jacoblgit/Ball-Beam-Robot/code/Ball-Beam/architecture_design/system_architecture.jpeg

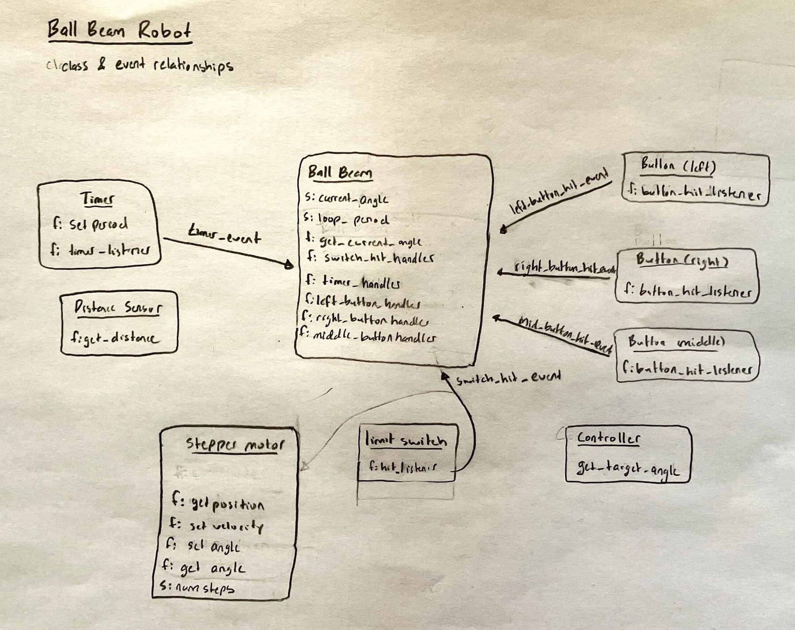
code/Ball-Beam/architecture_design/system_architecture.jpeg
