jacoblgit/Ball-Beam-Robot/portfolio/actual.JPG

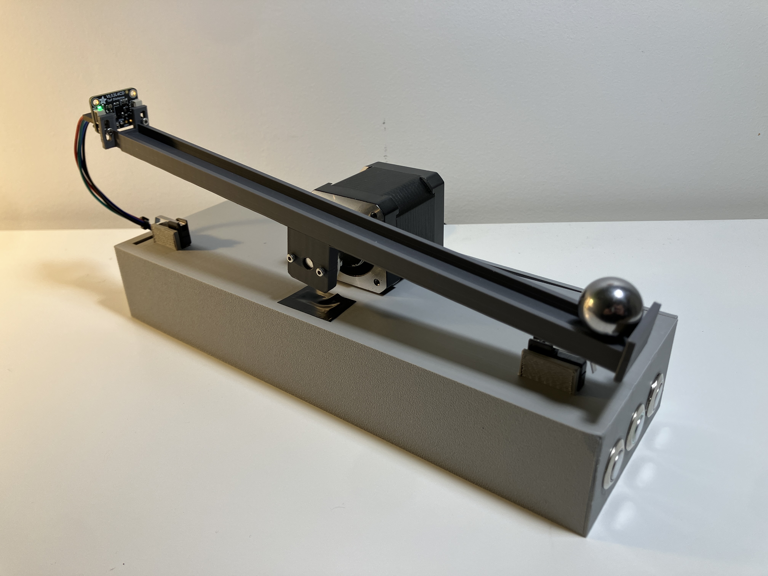
portfolio/actual.JPG
