jacoblgit/Ball-Beam-Robot/portfolio/altium.jpg

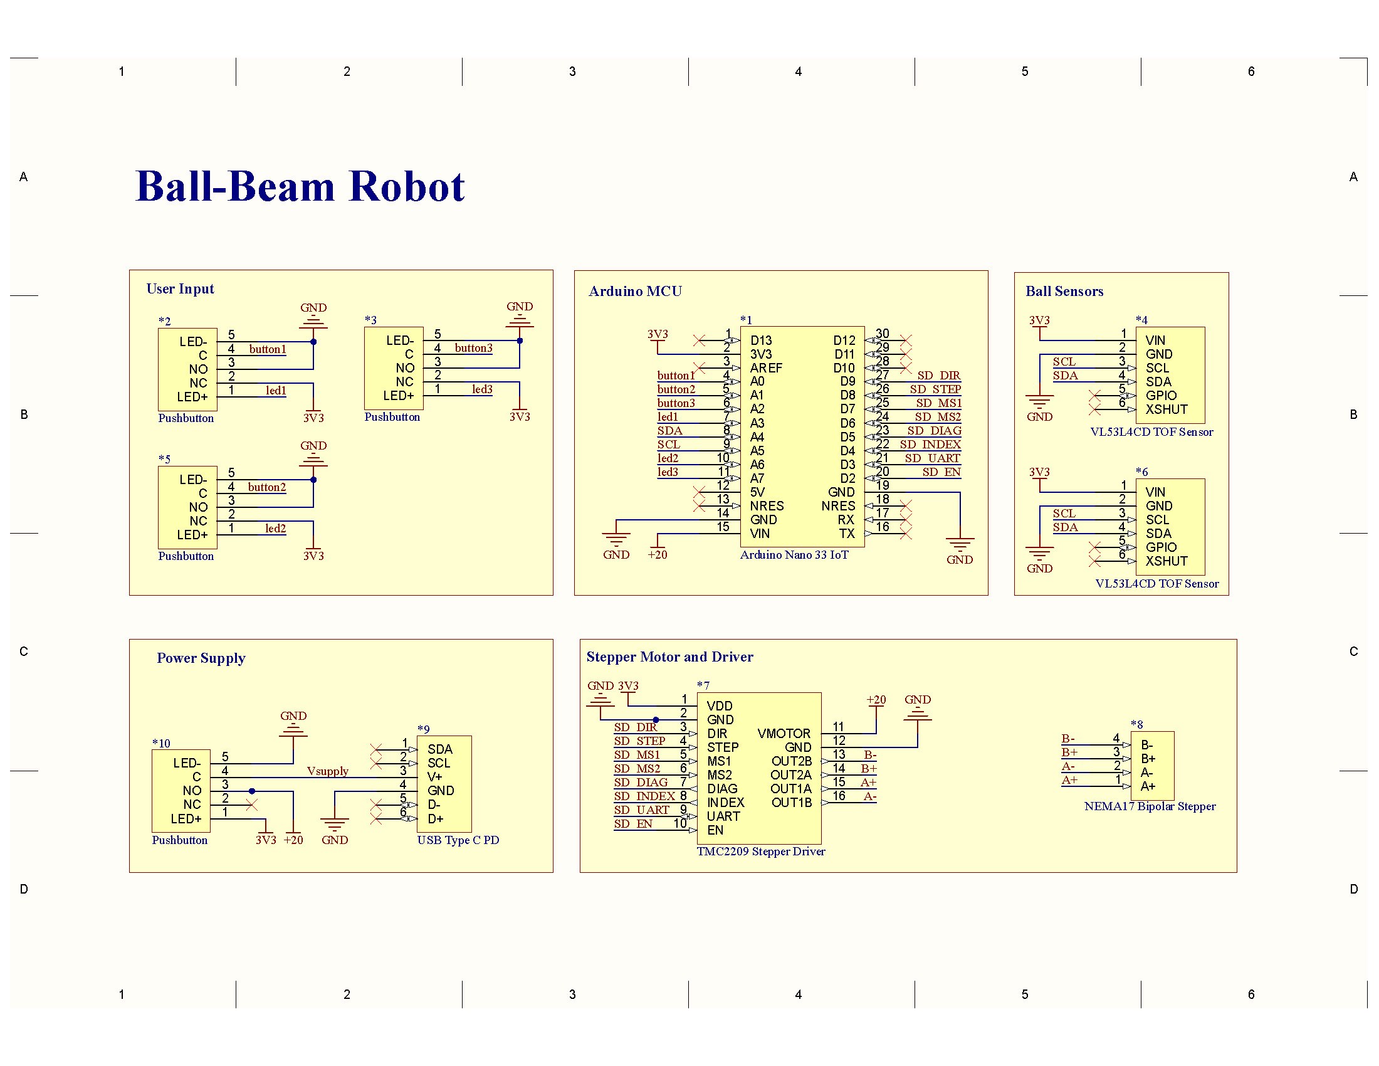
portfolio/altium.jpg
