jacoblgit/Ball-Beam-Robot/portfolio/cad.png

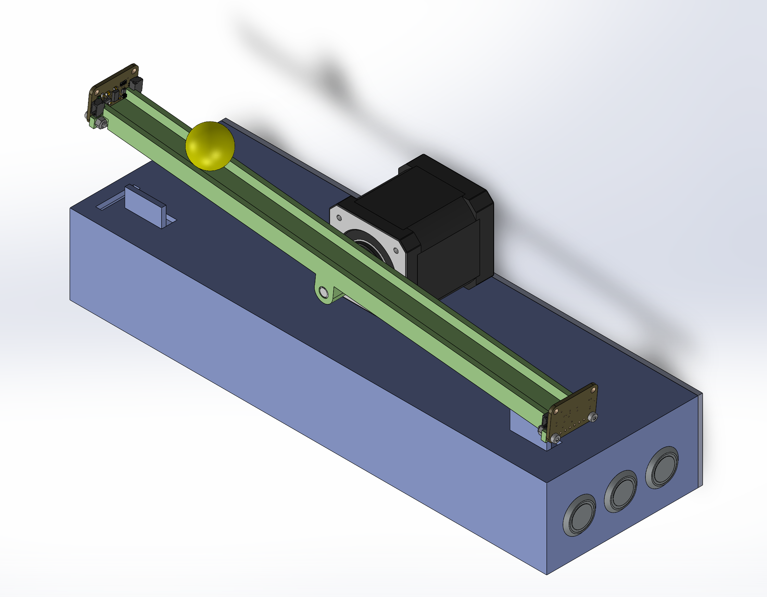
portfolio/cad.png
