jacoblgit/Ball-Beam-Robot/portfolio/matlab4.png

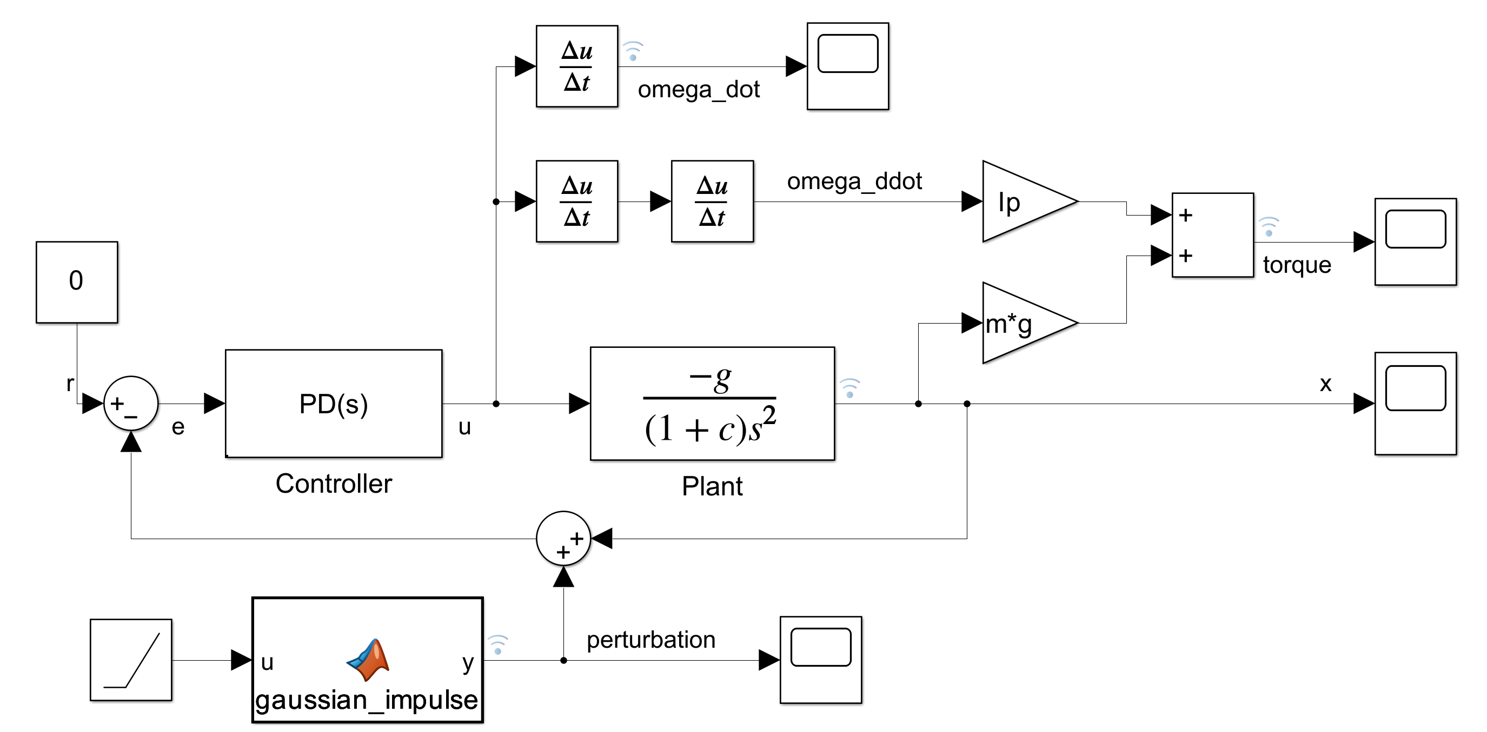
portfolio/matlab4.png
