jacoblgit/Ball-Beam-Robot/portfolio/Screenshot 2025-01-07 003946.png

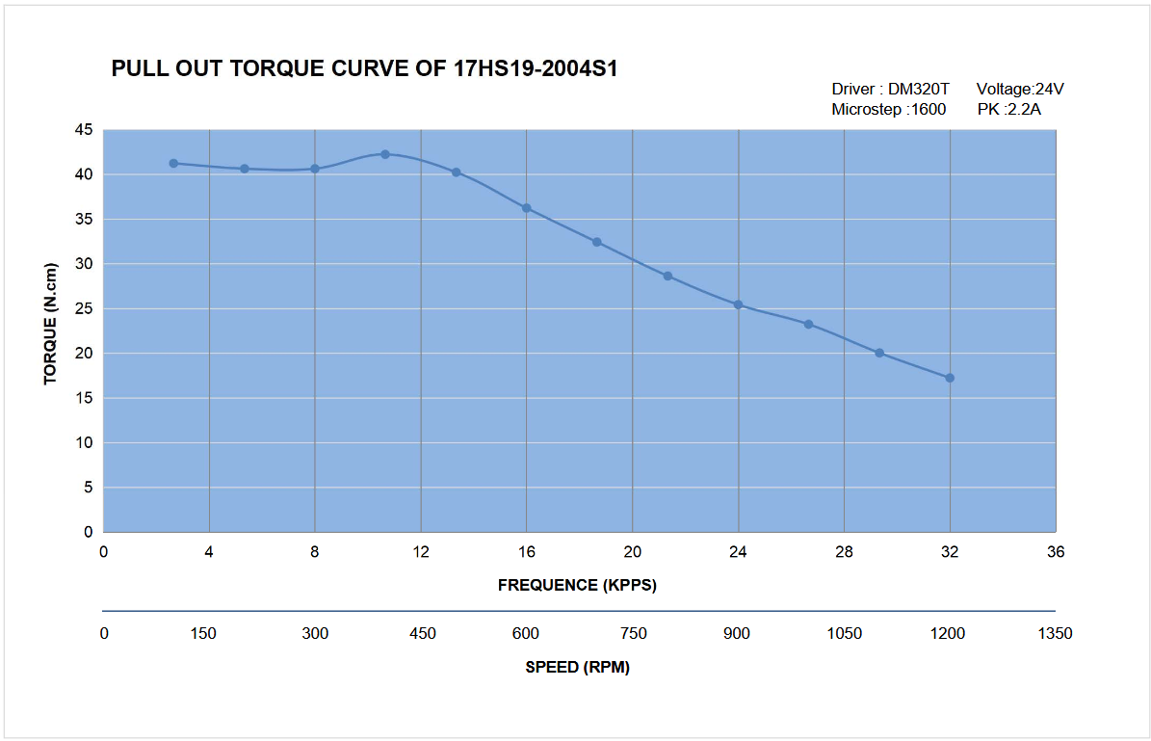
portfolio/Screenshot 2025-01-07 003946.png
