jacoblgit/Ball-Beam-Robot/CAW.xlsx

Ball Beam Cost Accounting Worksheet
Item | ID | Quantity | Price | Total | Link | Ordered
Electronics
Adafruit TMC2209 Stepper Motor Driver Breakout Board | 6121 | 1 | 8.95 | $8.95 | https://www.adafruit.com/product/6121 | 2025-01-15
Adafruit USB Type C Power Delivery Dummy Breakout - I2C or Fixed - HUSB238 | 5807 | 1 | 5.95 | $5.95 | https://www.adafruit.com/product/5807 | 2025-01-15
Adafruit VL53L4CD Time of Flight Distance Sensor | 5396 | 2 | $14.95 | $29.90 | https://www.adafruit.com/product/5396 | 2025-01-15
Rugged Metal On/Off Switch with White LED Ring - 16mm | 917 | 1 | $4.95 | $4.95 | https://www.adafruit.com/product/917 | 2025-01-15
Rugged Metal Pushbutton with White LED Ring - 16mm White Momentary | 558 | 3 | $4.95 | $14.85 | https://www.adafruit.com/product/558 | 2025-01-15
Arcade Button Quick-Connect Wire Pairs - 0.11" (10 pack) | 1152 | 2 | $4.95 | $9.90 | https://www.adafruit.com/product/1152 | 2025-01-15
Motor
Stepper Motor | 17HS19-2004S1 | 1 | $9.62 | $0.00 | https://www.omc-stepperonline.com/nema-17-bipolar-59ncm-84oz-in-2a-42x48mm-4-wires-w-1m-cable-connector-17hs19-2004s1 | personal stock
Motor Dampener | ST-D1 | 1 | $2.18 | $0.00 | https://www.omc-stepperonline.com/nema-17-stepper-motor-vibration-dampers-with-4-m3-screws-st-d1 | personal stock
Motor Bracket | ST-M1 | 1 | $1.84 | $1.84 | https://www.omc-stepperonline.com/nema-17-bracket-for-stepper-motor-and-geared-stepper-motor-alloy-steel-bracket-st-m1 | 2025-01-15
Power Transfer
GT2 Pinion | 3422-0005-0020 | 2 | $6.99 | $13.98 | https://www.servocity.com/2mm-pitch-gt2-pinion-timing-pulley-5mm-bore-20-tooth/ | 2025-01-15
5mm ID Non-Flanged Bearing | 1600-0410-0005 | 1 | $3.99 | $3.99 | https://www.servocity.com/5mm-id-x-10mm-od-non-flanged-ball-bearing-2-pack/ | 2025-01-15
5mm Shaft (Stainless Steel, 50mm Length) | 2100-0005-0050 | 1 | $1.59 | $1.59 | https://www.servocity.com/5mm-shaft-stainless-steel-50mm-length/ | 2025-01-15
2mm Pitch GT2 Timing Belt | 3423-0006-0088 | 1 | $1.49 | $1.49 | https://www.servocity.com/2mm-pitch-gt2-timing-belt-6mm-width-88mm-pitch-length-44-tooth/ | 2025-01-15
Miscelaneous
Assorted M2 M3 M4 M5 Nuts and Bolts | SYD-517 | 1 | $24.99 | $0 | https://a.co/d/aZ3D2kg | personal stock
3/4" chrome steel ball bearing | NA | 1 | $7.99 | $7.99 | https://a.co/d/1f6xndt | 2025-01-15
 |  |  | Total | $105.38
