jacoblgit/Ball-Beam-Robot/design/3D_printing/pillar.STL

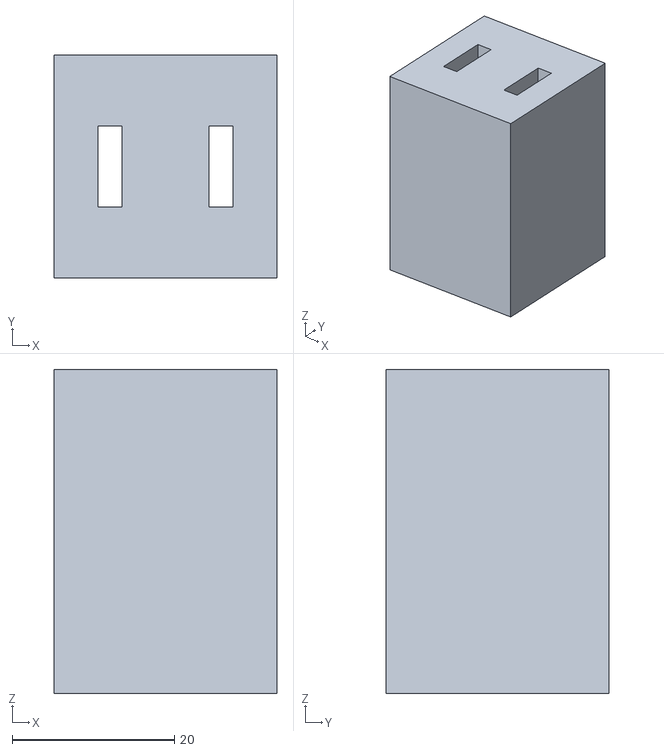
[picture p7: CAD file, 2025-01-11]
design/3D_printing/pillar.STL
27.5 x 27.5 x 40.0
