jacoblgit/Ball-Beam-Robot/design/back_cover.SLDPRT

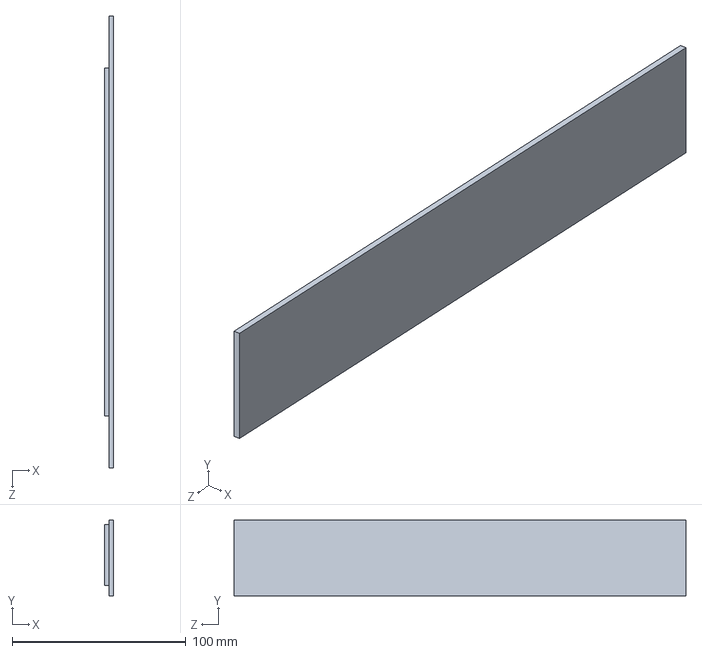
[picture p8: CAD file, 2025-05-26]
design/back_cover.SLDPRT
5.00 x 43.5 x 260.0 mm
