jacoblgit/Ball-Beam-Robot/design/electronics/OTS/5807 HUSB238 Breakout.step

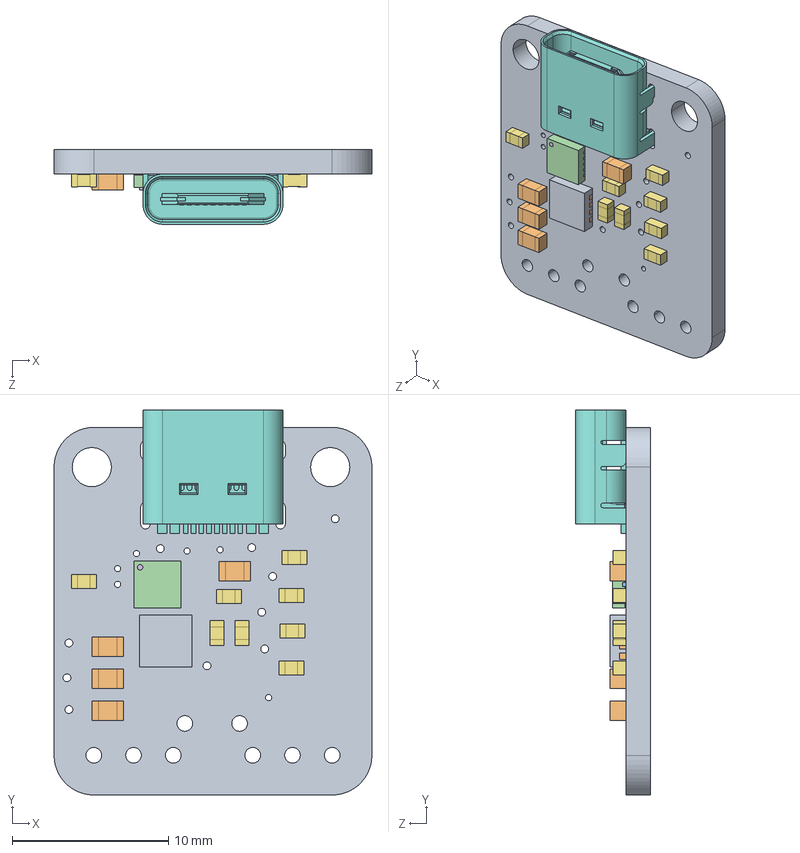
[picture p9: CAD file, 2025-01-18]
design/electronics/OTS/5807 HUSB238 Breakout.step
20.3 x 24.6 x 4.77 mm
Board.step
4.7uF.step x 4
HUSB238.step
14K.step x 8
USB Type C.step
AONR21307.step
