jacoblgit/Ball-Beam-Robot/design/3D_printing/pillar_pivot.STL

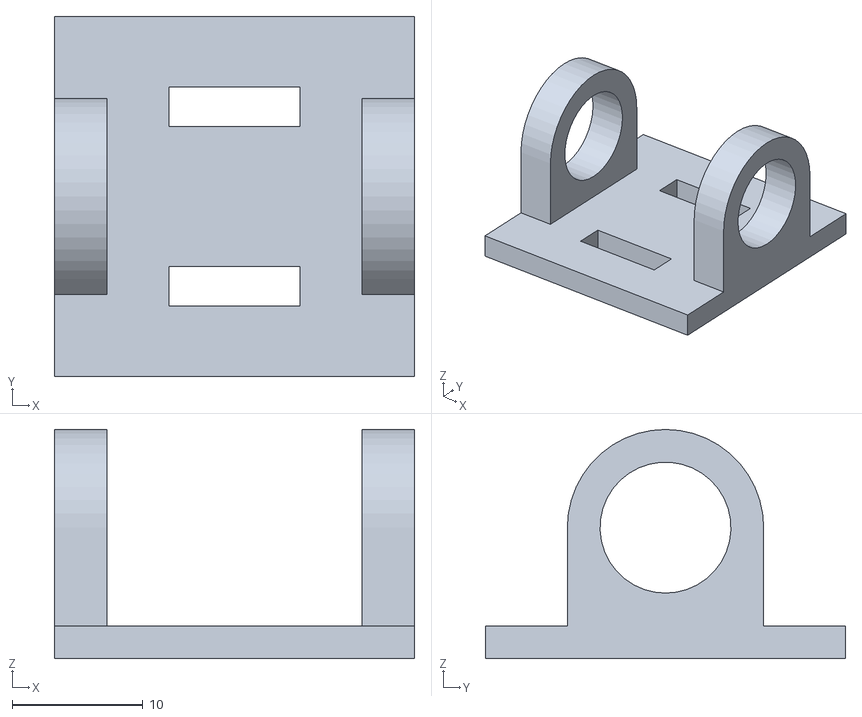
[picture p10: CAD file, 2025-01-11]
design/3D_printing/pillar_pivot.STL
27.5 x 27.5 x 17.5
