jacoblgit/Ball-Beam-Robot/design/track_v2.SLDPRT

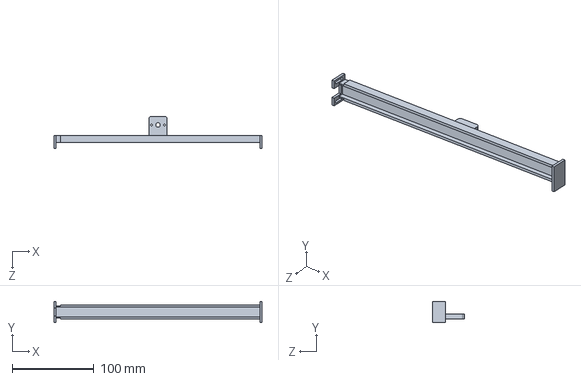
[picture p12: CAD file, 2025-05-26]
design/track_v2.SLDPRT
255.0 x 26.0 x 38.9 mm
