jacoblgit/Ball-Beam-Robot/design/ball.SLDPRT

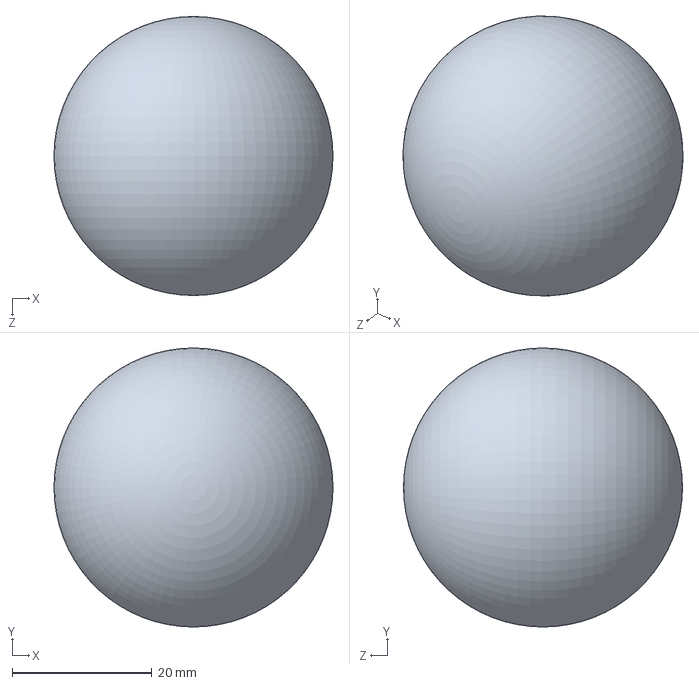
[picture p13: CAD file, 2025-05-26]
design/ball.SLDPRT
40.0 x 40.0 x 40.0 mm
