jacoblgit/Ball-Beam-Robot/design/track.SLDPRT

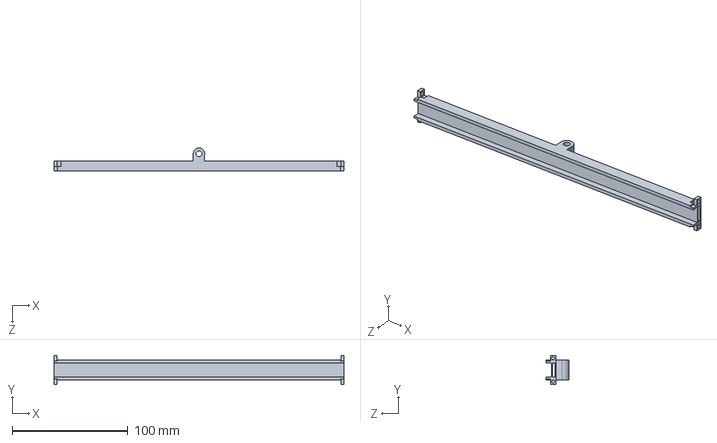
[picture p14: CAD file, 2025-05-26]
design/track.SLDPRT
250.1 x 25.4 x 20.0 mm
