jacoblgit/Ball-Beam-Robot/design/plate.SLDPRT

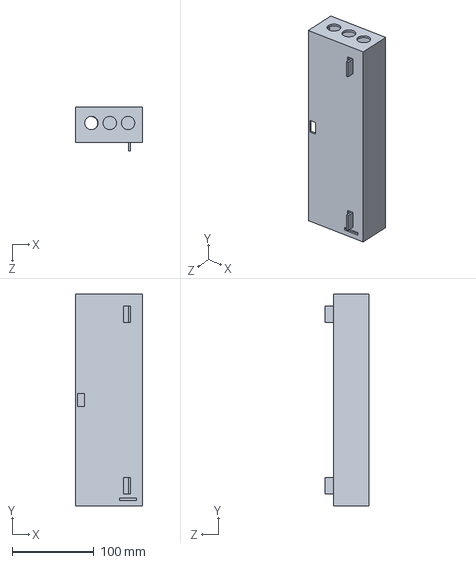
[picture p15: CAD file, 2025-05-26]
design/plate.SLDPRT
82.5 x 260.0 x 53.5 mm
