jacoblgit/Ball-Beam-Robot/design/OTS/Metal_Pushbutton_White.SLDPRT

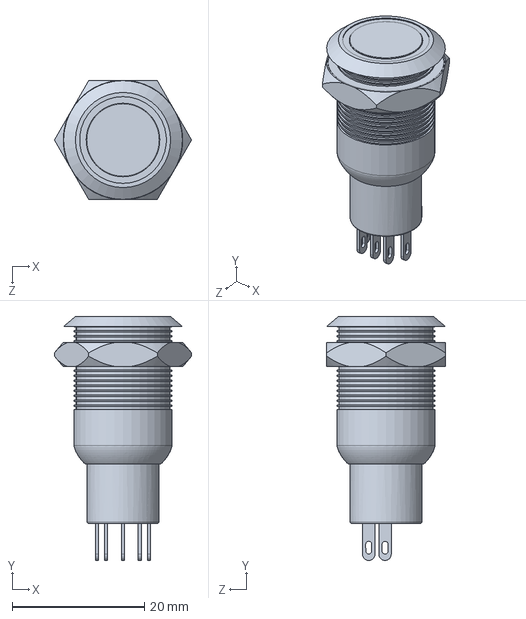
[picture p16: CAD file, 2025-01-07]
design/OTS/Metal_Pushbutton_White.SLDPRT
20.8 x 36.9 x 18.0 mm
