jacoblgit/Ball-Beam-Robot/design/OTS/17HS19-2004S1.STEP

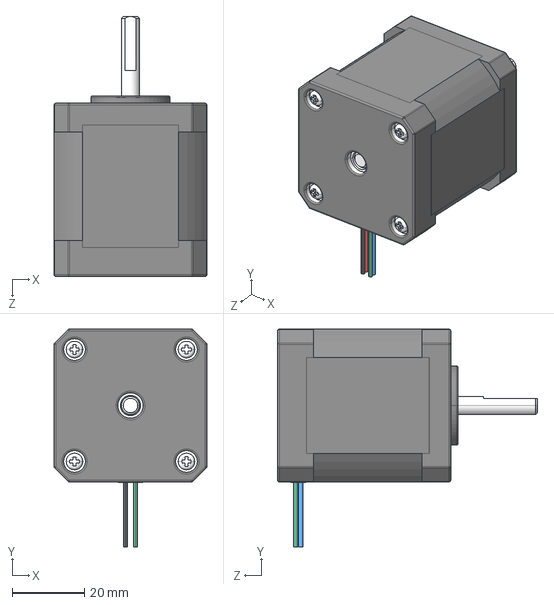
[picture p17: CAD file, 2025-01-05]
design/OTS/17HS19-2004S1.STEP
42.3 x 60.3 x 72.0 mm
