jacoblgit/Ball-Beam-Robot/design/OTS/3422-0005-0020.STEP

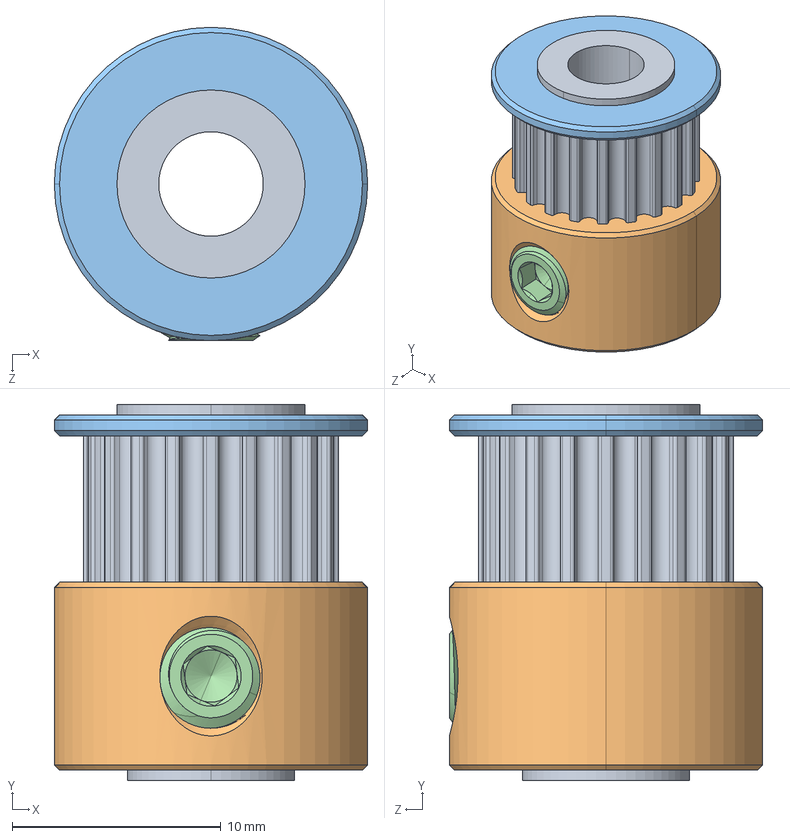
[picture p18: CAD file, 2025-01-05]
design/OTS/3422-0005-0020.STEP
15.0 x 18.0 x 15.0 mm
3422-0005-0020 core
3422 series barrel
3422 series flange
2806-0005-0005_91390A117
