jacoblgit/Ball-Beam-Robot/design/OTS/ST-M1.STEP

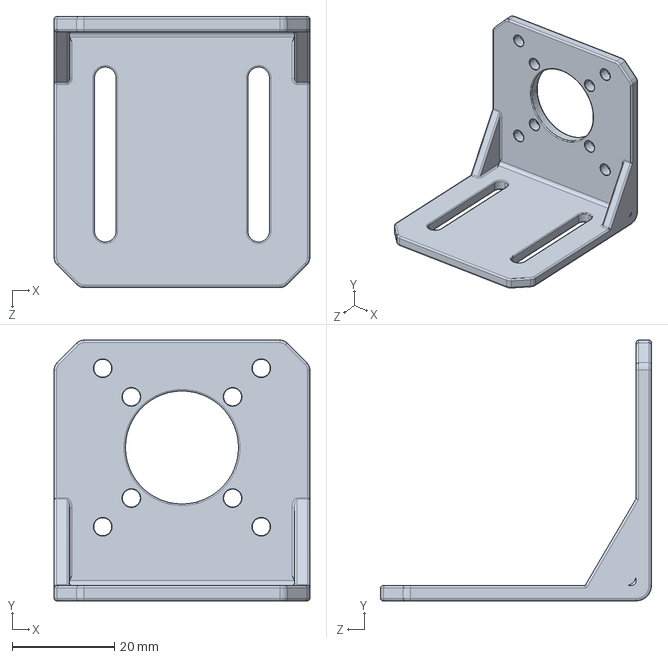
[picture p19: CAD file, 2025-01-05]
design/OTS/ST-M1.STEP
50.0 x 51.0 x 53.0 mm
