jacoblgit/Ball-Beam-Robot/design/OTS/Nema17-Damper.stp

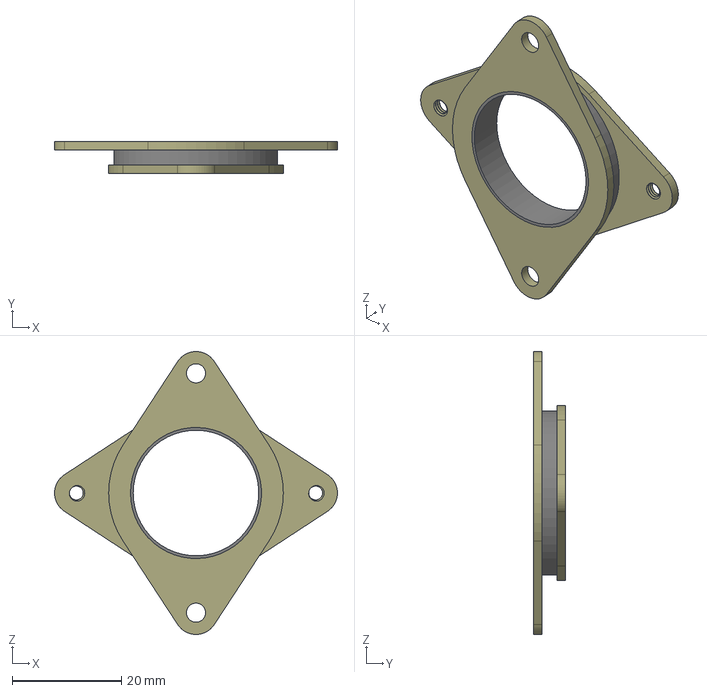
[picture p20: CAD file, 2025-01-05]
design/OTS/Nema17-Damper.stp
51.8 x 5.90 x 51.8 mm
