jacoblgit/Ball-Beam-Robot/design/OTS/2100-0005-0050.STEP

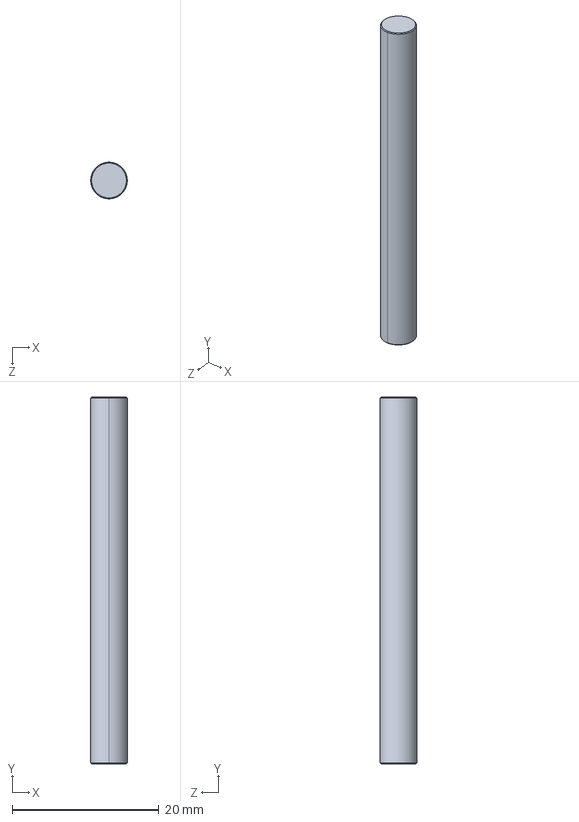
[picture p21: CAD file, 2025-01-05]
design/OTS/2100-0005-0050.STEP
5.00 x 50.0 x 5.00 mm
