jacoblgit/Ball-Beam-Robot/design/OTS/90576A211_Medium-Strength Steel Nylon-Insert Locknut.SLDPRT

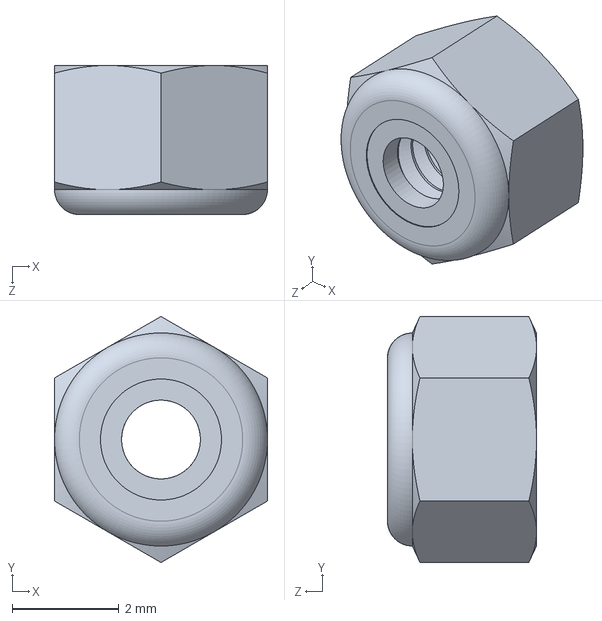
[picture p22: CAD file, 2025-01-08]
design/OTS/90576A211_Medium-Strength Steel Nylon-Insert Locknut.SLDPRT
4.00 x 4.62 x 2.80 mm
