jacoblgit/Ball-Beam-Robot/design/OTS/90037A110_High-Strength 316 Stainless Steel Socket Head Screw.SLDPRT

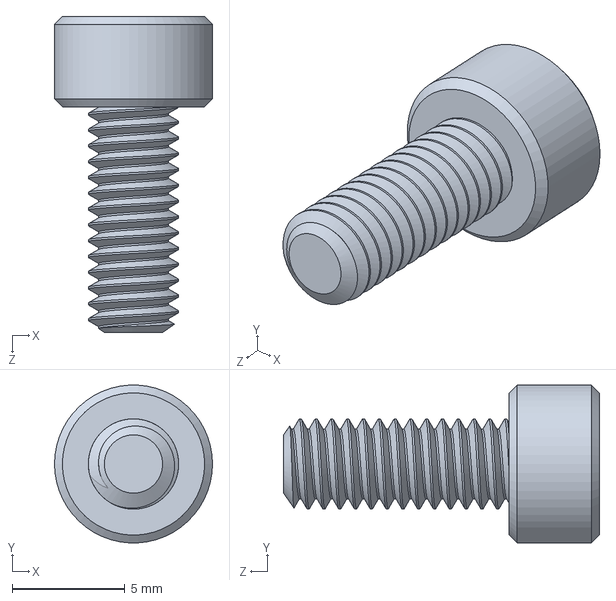
[picture p23: CAD file, 2025-01-08]
design/OTS/90037A110_High-Strength 316 Stainless Steel Socket Head Screw.SLDPRT
7.00 x 6.99 x 14.0 mm
