jacoblgit/Ball-Beam-Robot/design/system.SLDASM

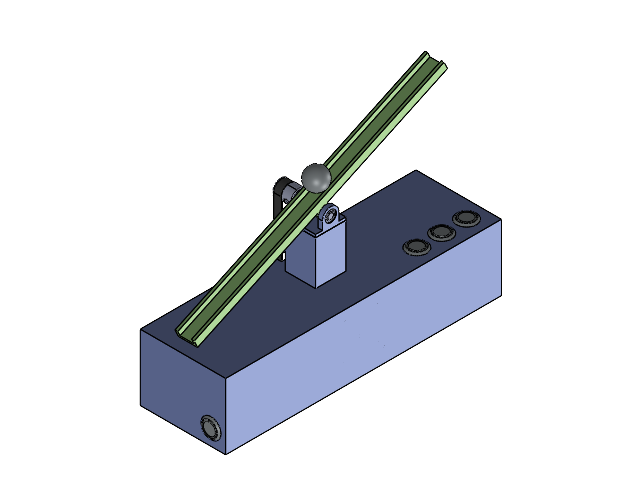
[picture p24: CAD file, 2025-01-07]
design/system.SLDASM
track
ball
plate
17HS19-2004S1.step
ST-M1.step
Nema17-Damper.stp
3422-0005-0020 core.STEP x 2
3422 series barrel.STEP x 2
3422 series flange.STEP x 2
2806-0005-0005_91390A117.STEP x 2
pillar
535229.step x 2
pillar_pivot
2100-0005-0050.step
Metal_Pushbutton_White x 4
Belt1-1^system
