jacoblgit/Ball-Beam-Robot/(list of files, cad)

Other CAD files:
design/3D_printing/back_cover.STL
design/3D_printing/plate.STL
design/3D_printing/track.STL
design/OTS/535229.STEP
design/OTS/90037A102_High-Strength 316 Stainless Steel Socket Head Screw.SLDPRT
design/OTS/90037A103_High-Strength 316 Stainless Steel Socket Head Screw.SLDPRT
design/OTS/94645A101_High-Strength Steel Nylon-Insert Locknut.SLDPRT
