jacoblgit/Ball-Beam-Robot/code/Ball-Beam/architecture_design/Clock cycles required for single step pulse initiated by an interrupt.pdf

## Processor Usage by Motor Control Interrupts

One approach to running the stepper is having an interrupt which pulses the step pin. My concern is that this interrupt will consume too many processor cycles. As shown by the calculations below, this concern is unfounded, as running the motor will take worst case 1.33% of CPU cycles.

### Clock cycles required for single step pulse initiated by an interrupt:

Operation | Worst Case (# cycles)
Interrupt Entry | 15
Direct port set | 1
Hold on high | 7
Direct port clear | 1
Increment position counter | 1
Interrupt Return | 15
Total | 40

### Number of Interrupts per second:

My simulations showed the motor speed was below 600RPM. 600RPM is 10 rot/sec which, at 1600 microstepping, is 16000 steps per sec. With 40 cycles per step, this is 640,000 cycles. The processor is 48MHz, so that’s a mere 1.33% of clock cycles.

## References

Interrupt Entry

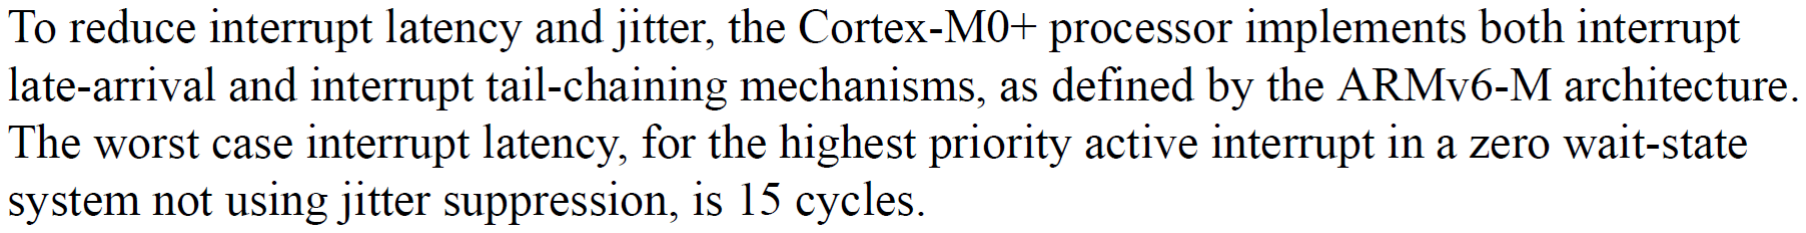
[picture p25: figure]

(Cortex M0 Technical Reference Manual, 3.6.1 Exception Handling) Direct Port Set High

(Cortex M0 Technical Reference Manual, 3.3 Instruction Set Summary)
1 clock cycle if word is written to single-cycle I/O port, which is what I’m doing

Hold on High

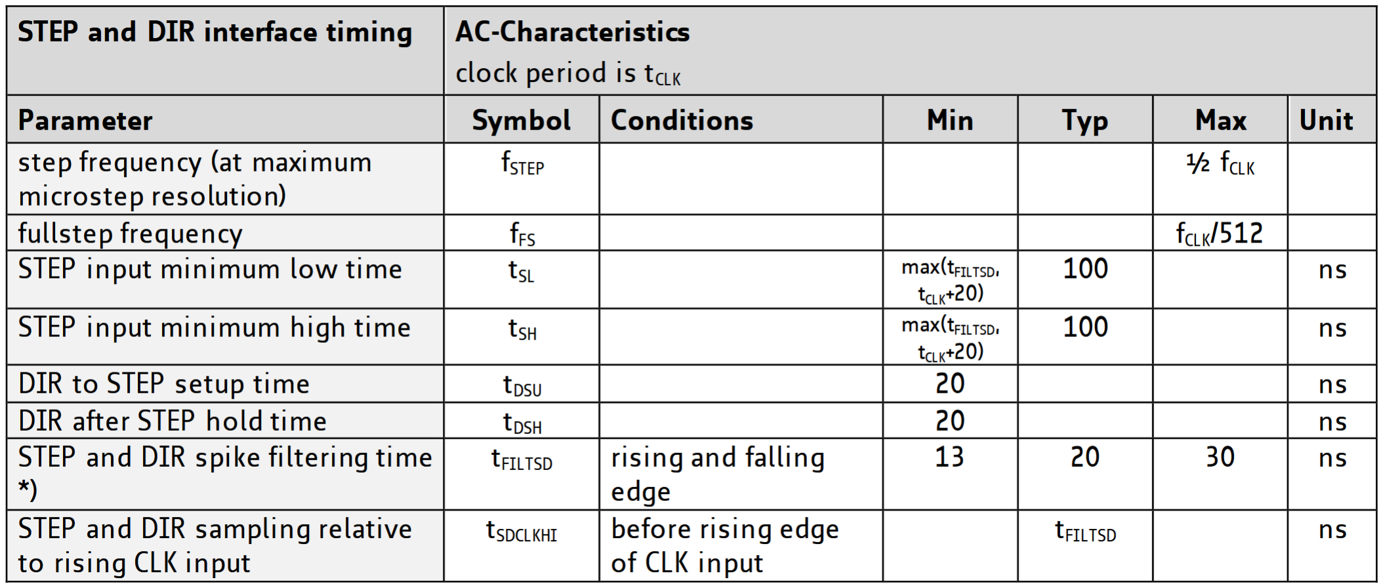
[picture p26: figure]

(TMC2209 Stepper Motor Driver Datasheet, 13.1 STEP/DIR Interface Timing)
48Mhz is 20 ns per cycle. 100 ns STEP input minimum high time typical means the processor should hold the output high for at least 5 clock cycles (let’s say 7 to be safe)
Direct Port Set High
Same as direct port set
Increment Position Counter

(Cortex M0 Technical Reference Manual, 3.3 Instruction Set Summary)
Interrupt Return
I could not find in the datasheets a number for the clock cycles required on interrupt return, but I certainly would not expect it to be more than the number required for interrupt entry, so I’m using that as my worst case bound.
