jacoblgit/Ball-Beam-Robot/analysis/filter_tuning/run_data.csv

run_data
265
268
269
270
273
275
272
270
269
269
260
258
255
252
246
239
235
230
224
225
220
218
216
211
209
203
204
201
200
193
191
187
183
182
177
175
170
166
166
163
162
159
158
156
155
152
153
147
146
140
139
135
136
131
131
128
130
128
127
123
122
122
119
119
120
118
118
118
120
120
121
123
122
125
123
124
127
128
125
131
132
133
135
138
137
136
135
132
142
135
134
134
135
134
132
134
129
132
131
131
129
128
127
126
124
127
123
123
122
124
123
125
124
125
125
122
126
124
126
130
128
126
129
131
127
131
135
129
133
134
133
138
136
136
139
141
143
145
145
143
147
144
149
146
151
154
155
158
156
156
160
161
162
160
164
167
168
175
173
177
178
179
184
180
189
192
194
199
200
205
204
208
210
214
216
221
223
227
229
230
236
233
238
241
242
243
244
246
243
241
245
243
235
237
234
231
231
224
225
223
222
214
212
203
206
204
200
196
194
191
187
184
183
181
176
172
172
168
168
160
158
157
155
150
146
142
137
137
130
127
121
116
114
112
109
106
101
95
95
92
88
84
80
81
80
74
75
73
73
70
65
69
70
66
72
67
73
73
75
77
81
77
81
85
83
89
90
92
93
96
102
100
103
104
107
109
109
111
110
112
112
111
111
113
111
112
112
111
110
107
108
109
105
103
102
99
96
96
95
90
88
85
86
82
80
78
78
76
72
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
