jacoblgit/Ball-Beam-Robot/portfolio/simulation_result.png

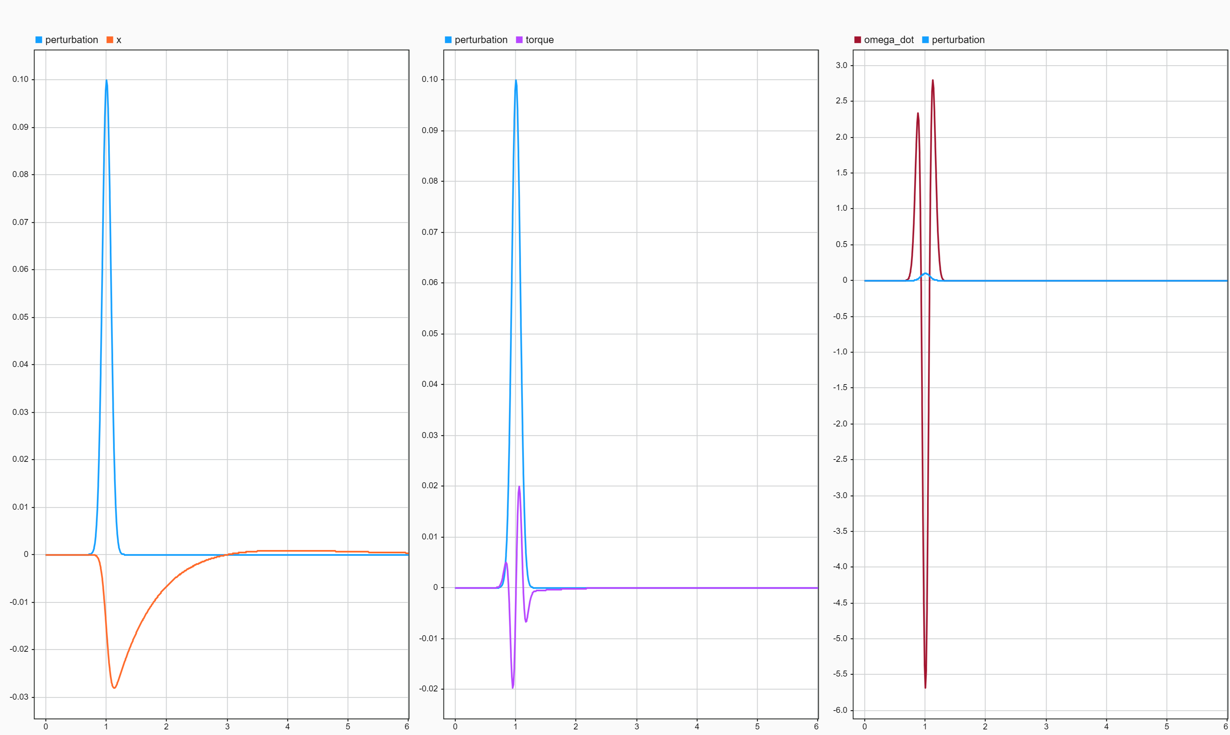
portfolio/simulation_result.png
