jacoblgit/Ball-Beam-Robot/electronics/schematic.pdf

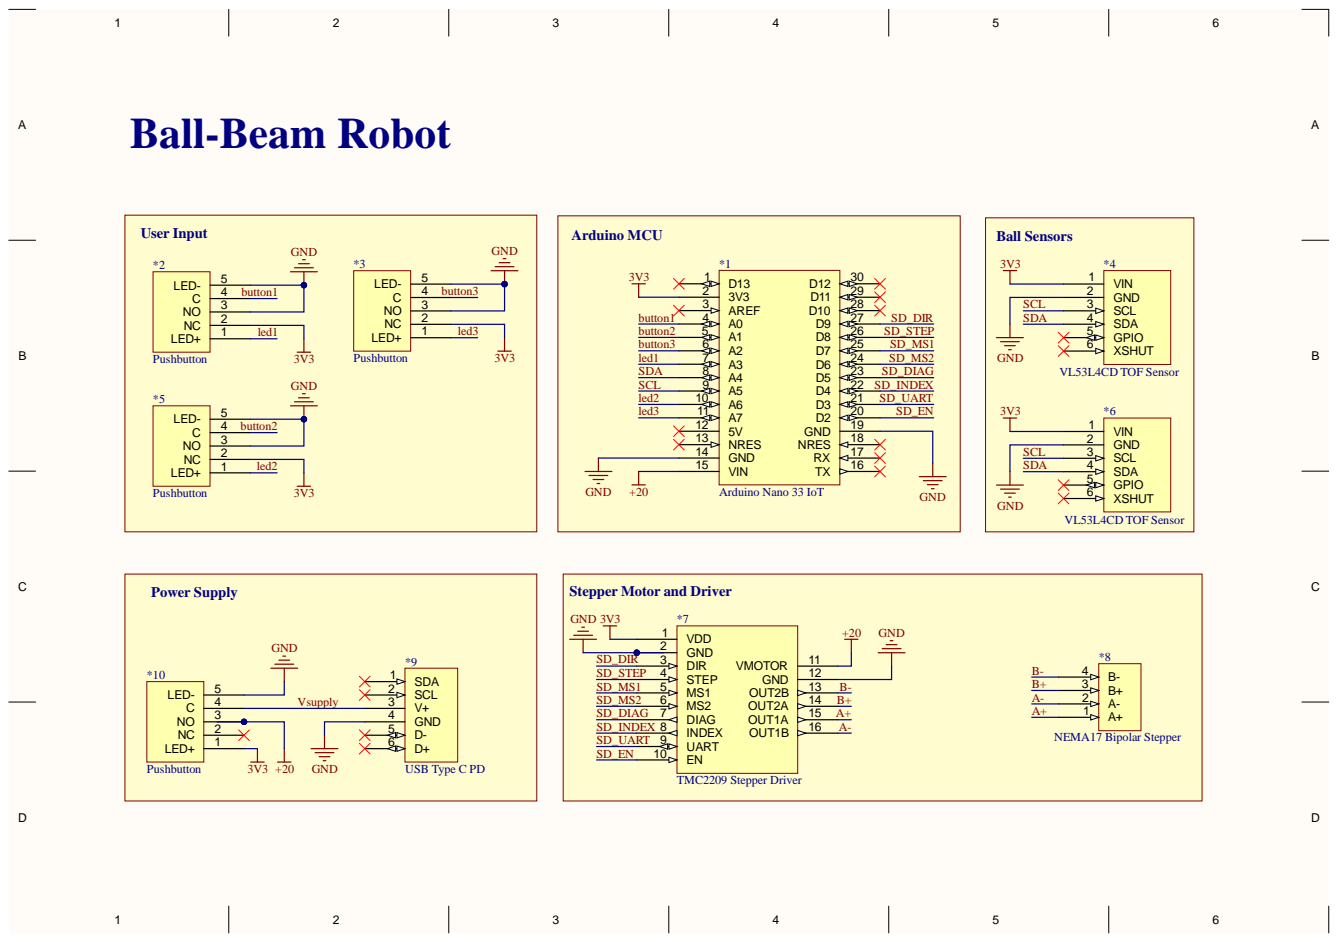
[picture p28: page 1]

Stepper Motor and Driver
