jacoblgit/Ball-Beam-Robot/(list of files, drawings)

Other design files:
design/electronics/ball-on-beam.fzz
