jacoblgit/Ball-Beam-Robot/code/Ball-Beam/src/BallBeam/Test.cpp

#include "test.hpp"

namespace Test {
    // Run with:
    // Test::test_stepper(stepper, STEPS_PER_REV);
    void test_stepper(Stepper& stepper, uint16_t steps_per_rev) {
        Serial.println("Starting stepper motor test...");
        
        // Set direction to clockwise and start stepping
        Serial.println("Setting direction to CW and starting motor...");
        // stepper.set_steps_per_sec(steps_per_rev / 36);
        stepper.set_rad_per_sec(2*PI/36);
        stepper.start_stepping();
        
        // Wait 1 second
        delay(1000);
        
        // Print step count after 1 second of CW rotation
        Serial.print("Step count after 1 second CW: ");
        Serial.println(stepper.get_step_count());
        Serial.print("Angle after 1 second CW: ");
        Serial.println(stepper.get_angle() * 360/(2*PI), 4);
        

        // Set direction to counter-clockwise and continue stepping
        Serial.println("Setting direction to CCW and continuing...");
        stepper.set_rad_per_sec(-2*PI/36);
        stepper.start_stepping();
        
        // Wait 1 more second
        delay(2000);
        
        // Stop stepping
        stepper.stop_stepping();
        
        // Print step count after 2 second of CCW rotation
        Serial.print("Step count after 2 second CCW: ");
        Serial.println(stepper.get_step_count());
        Serial.print("Angle after 2 second CCW: ");
        Serial.println(stepper.get_angle()* 360/(2*PI), 4);
        
        // Set direction to clockwise and start stepping
        Serial.println("Setting direction to CW and starting motor...");
        stepper.set_rad_per_sec(2*PI/36);
        stepper.start_stepping();
        
        // Wait 1 second
        delay(1000);
        
        // Print step count after 1 second of CW rotation
        stepper.stop_stepping();
        Serial.print("Step count after 1 second CW: ");
        Serial.println(stepper.get_step_count());
        Serial.print("Angle after 1 second CW: ");
        Serial.println(stepper.get_angle()* 360/(2*PI), 4);

        
        Serial.println("Stepper motor test complete.");
    }

    void test_distance_sensor(DistanceSensor& sensor, uint32_t LOOP_PERIOD_MS) {        
        // Initialize the sensor
        sensor.initialize();
        
        // print sensor value
        float distance = sensor.get_distance();
        if (distance >= 0) {
            Serial.print("Distance: ");
            Serial.print(distance);
            Serial.println(" mm");
        } else {
            Serial.println("Invalid distance reading");
        }
        delay(LOOP_PERIOD_MS);
    }
}
