jacoblgit/Ball-Beam-Robot/(commit log)

2025-01-04 fix numerical issue with simulation by changing input step function to logistic function. calculate angular velocity and acceleration and verify motor is capable of driving system. add datasheets for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
    [system.SLDASM, system_parameters.xlsx, track.SLDPRT]
2025-01-05 add torque and ang. velocity measurements to simulink
2025-01-05 tune PID
2025-01-05 add motor, track, base, support to 3d model
    [17HS19-2004S1.STEP, 2100-0005-0050.STEP, 3422-0005-0020.STEP, 535229.STEP, CAW.xlsx, Nema17-Damper.stp, ST-M1.STEP, ball.SLDPRT]
2025-01-05 move motor to cavity under plate
    [CAW.xlsx, pillar.SLDPRT, plate.SLDPRT, system.SLDASM, system_parameters.xlsx]
2025-01-06 added belt
    [CAW.xlsx, ball.SLDPRT, pillar.SLDPRT, pillar_pivot.SLDPRT, plate.SLDPRT, system.SLDASM, track.SLDPRT]
2025-01-07 add buttons
    [CAW.xlsx, Metal_Pushbutton_White.SLDPRT, pillar.SLDPRT, pillar_pivot.SLDPRT, plate.SLDPRT, system.SLDASM, track.SLDPRT]
2025-01-08 add sensor and nuts and bolts
    [5396 Adafruit VL53L4CD.step, 90037A102_High-Strength 316 Stainless Steel Socket Head Screw.SLDPRT, 90037A103_High-Strength 316 Stainless Steel Socket Head Screw.SLDPRT, 90037A110_High-Strength 316 Stainless Steel Socket Head Screw.SLDPRT, 90576A211_Medium-Strength Steel Nylon-Insert Locknut.SLDPRT, 94645A101_High-Strength Steel Nylon-Insert Locknut.SLDPRT, CAW.xlsx, pillar.SLDPRT]
2025-01-11 add sensor wire slot, prepare for 3d print
    [pillar.SLDPRT, pillar.STL, pillar_pivot.SLDPRT, pillar_pivot.STL, plate.3mf, plate.SLDPRT, plate.STL, track.SLDPRT]
2025-01-18 init code
    [5807 HUSB238 Breakout.step, CAW.xlsx, ball-on-beam.fzz, plate.3mf, track_and_supports.3mf]
2025-02-19 add architecture planning, controller hpp, distance sensor hpp, stepper initial implmentation, main initial implementation, cortex m0 datasheets, stepper controller datasheet
2025-02-19 add controller and distance sensor initial interface
2025-02-28 implement stepper class
2025-03-04 implement distance sensor
2025-04-01 fix bug with stepper
    [Controller.hpp, Stepper.cpp, main.cpp]
2025-04-01 add testing script for stepper
2025-04-15 working distance sensor test
2025-04-15 clean up distance sensor test
2025-04-22 make track press fit on stepper motor axel
    [stepper_press_fit_test.STL, track.SLDPRT, track2.STL]
2025-05-10 best working pd control, added filter
2025-05-11 new pid tunings
2025-05-15 transition to new simplified design
    [pillar.SLDPRT, pillar_pivot.SLDPRT, plate.3mf, plate.SLDPRT, plate.STL, stepper_press_fit_test.STL, system_simplified.SLDASM, track.SLDPRT]
2025-05-16 add switches
2025-05-26 complete ballbeam project
    [back_cover.SLDPRT, back_cover.STL, ball.SLDPRT, plate.SLDPRT, plate.STL, run_data2.csv, track.SLDPRT, track.STL]
2025-05-26 clean up project
    [system_parameters.xlsx]
